marove2000/OwlThief/(notices)

Notices in the files:
KiCad_Files/owlThief.kicad_pcb:
CC-BY-SA 4.0
